Joe-Para/LSI_OTD/README.md

# LSI_OTD

A project for building the hardware and software for measuring time delay on fiber cables in distributed measurmeent systems.
