Joe-Para/LSI_OTD/PCB/Image file SchematicV1.1.png

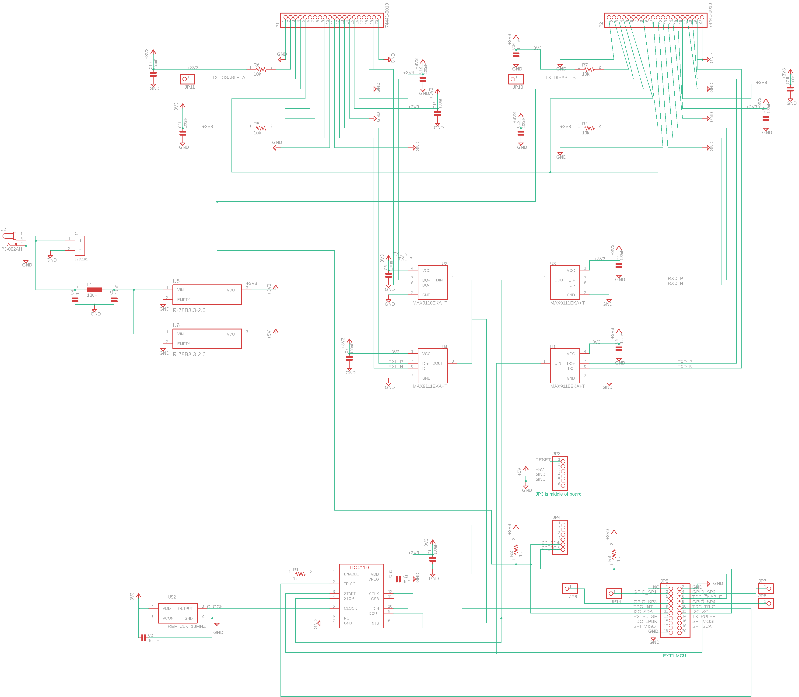
PCB/Image file SchematicV1.1.png
