Joe-Para/LSI_OTD/(threads)

Thread 1 (2019-04-17):

PCB Issues

Joe-Para, 2019-04-17:
- Need 5v switch with silkscreen warning
- SFP footprint lines up incorrectly
- Oscillator pads are a little small
- add more test points
- some silkscreen conflicts
- add footprint for sfp cages
- did not implement 4pin power header to MCU (mcu will need usb power)
- it would be nice to incorporate the RESET button on the display to the MCU (but i dont think there is room on the header)

-Edit: SFP Transceiver causes power to ground fault when plugged in

Joe-Para, 2019-04-24:
also oscillator datasheet recommends a 0.1uf cap as close as possible to the oscillator vdd and ground pins

Joe-Para, 2019-05-09:
Tim fixed all issues on pcb v2

Closed 2019-05-09.
