Joe-Para/LSI_OTD/PCB/SARA.pdf

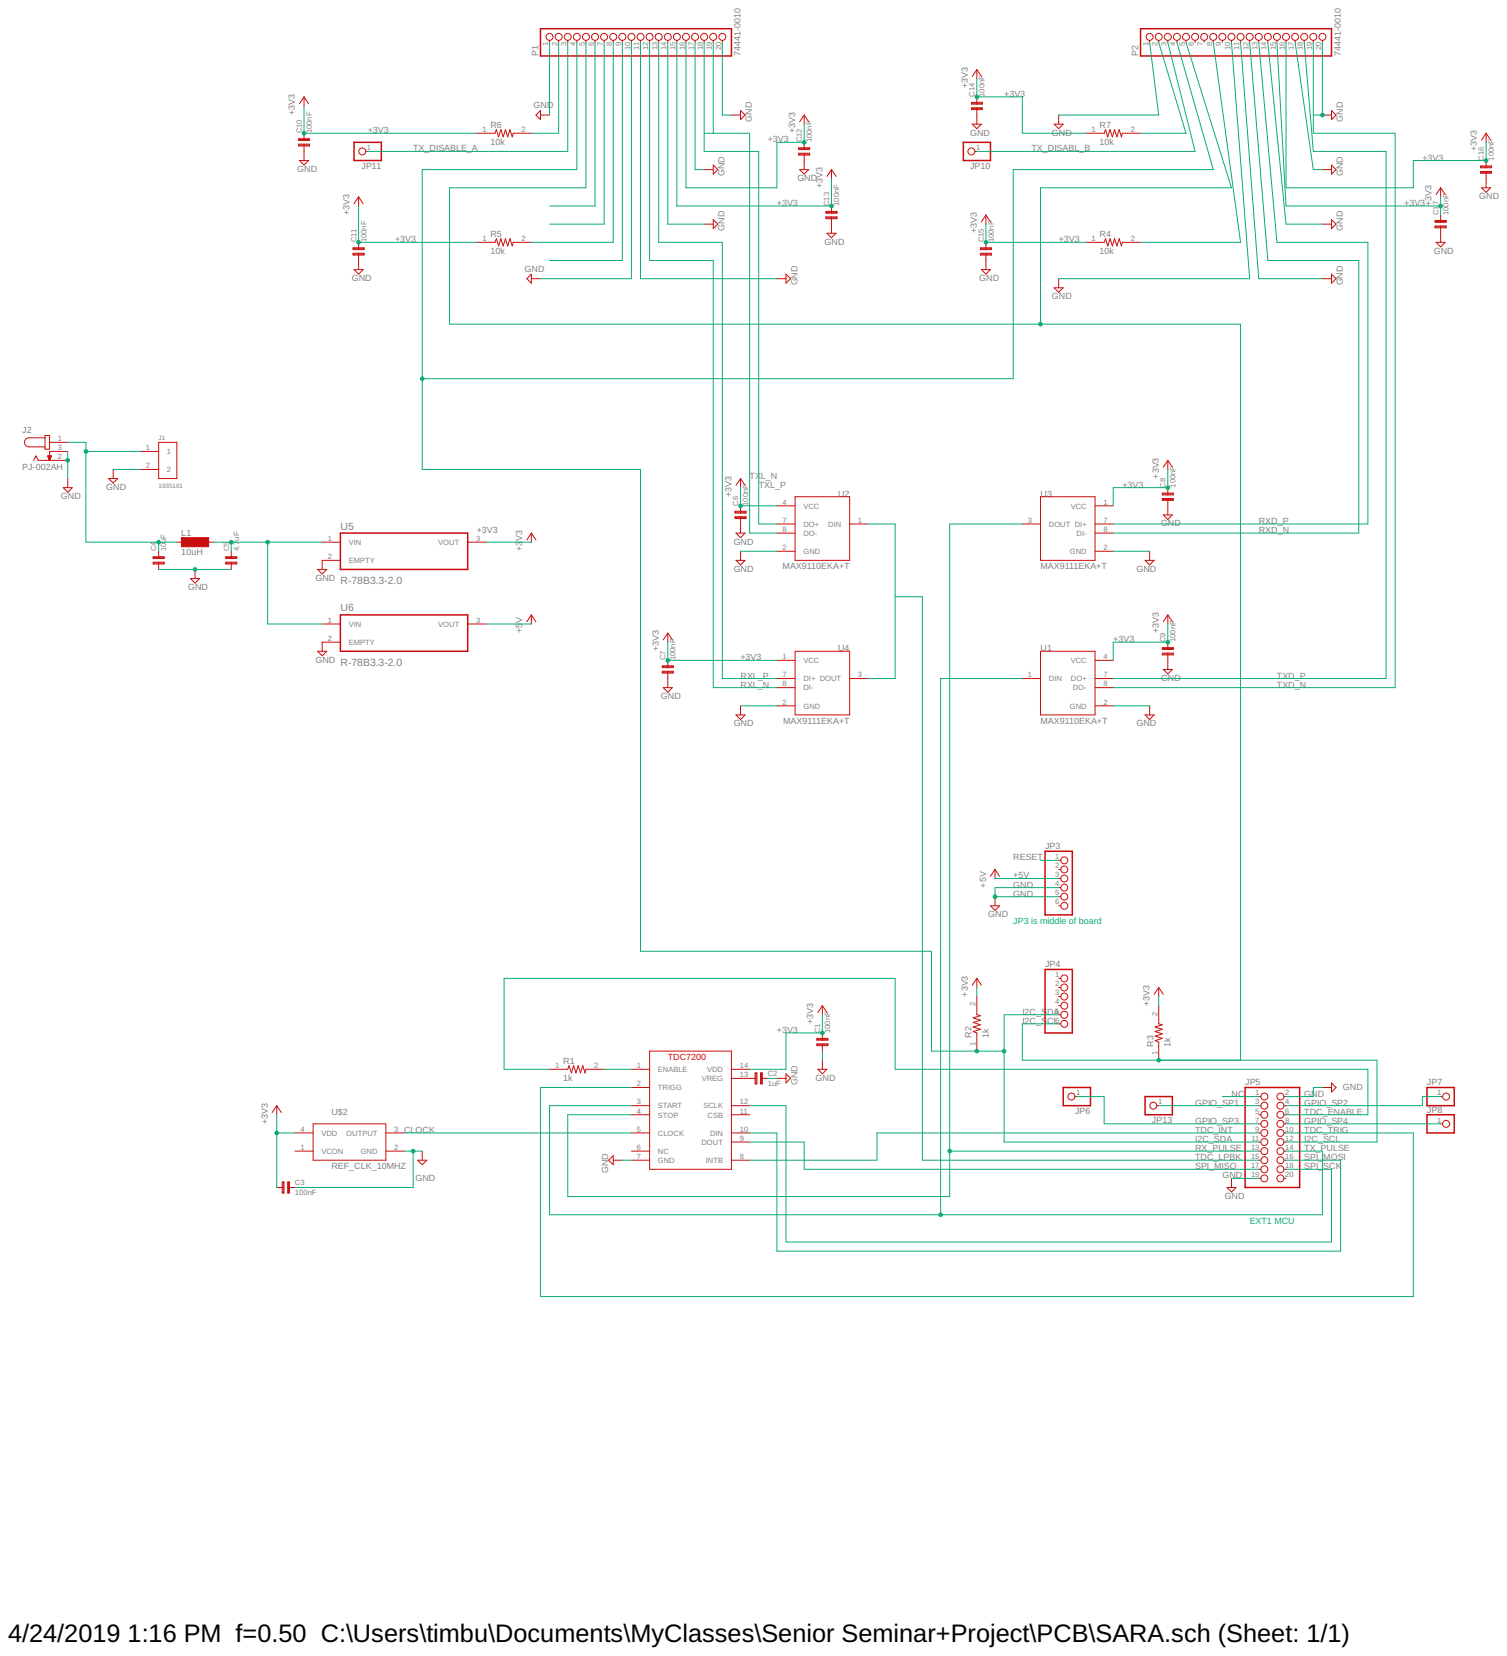
[picture p2: page 1]

JP3 is middle of board

4/24/2019 1:16 PM f=0.50 C:\Users\timbu\Documents\MyClasses\Senior Seminar+Project\PCB\SARA.sch (Sheet: 1/1)
