Joe-Para/LSI_OTD/PCB/SARA.brd

## EAGLE design PCB/SARA.brd (2019-05-14)

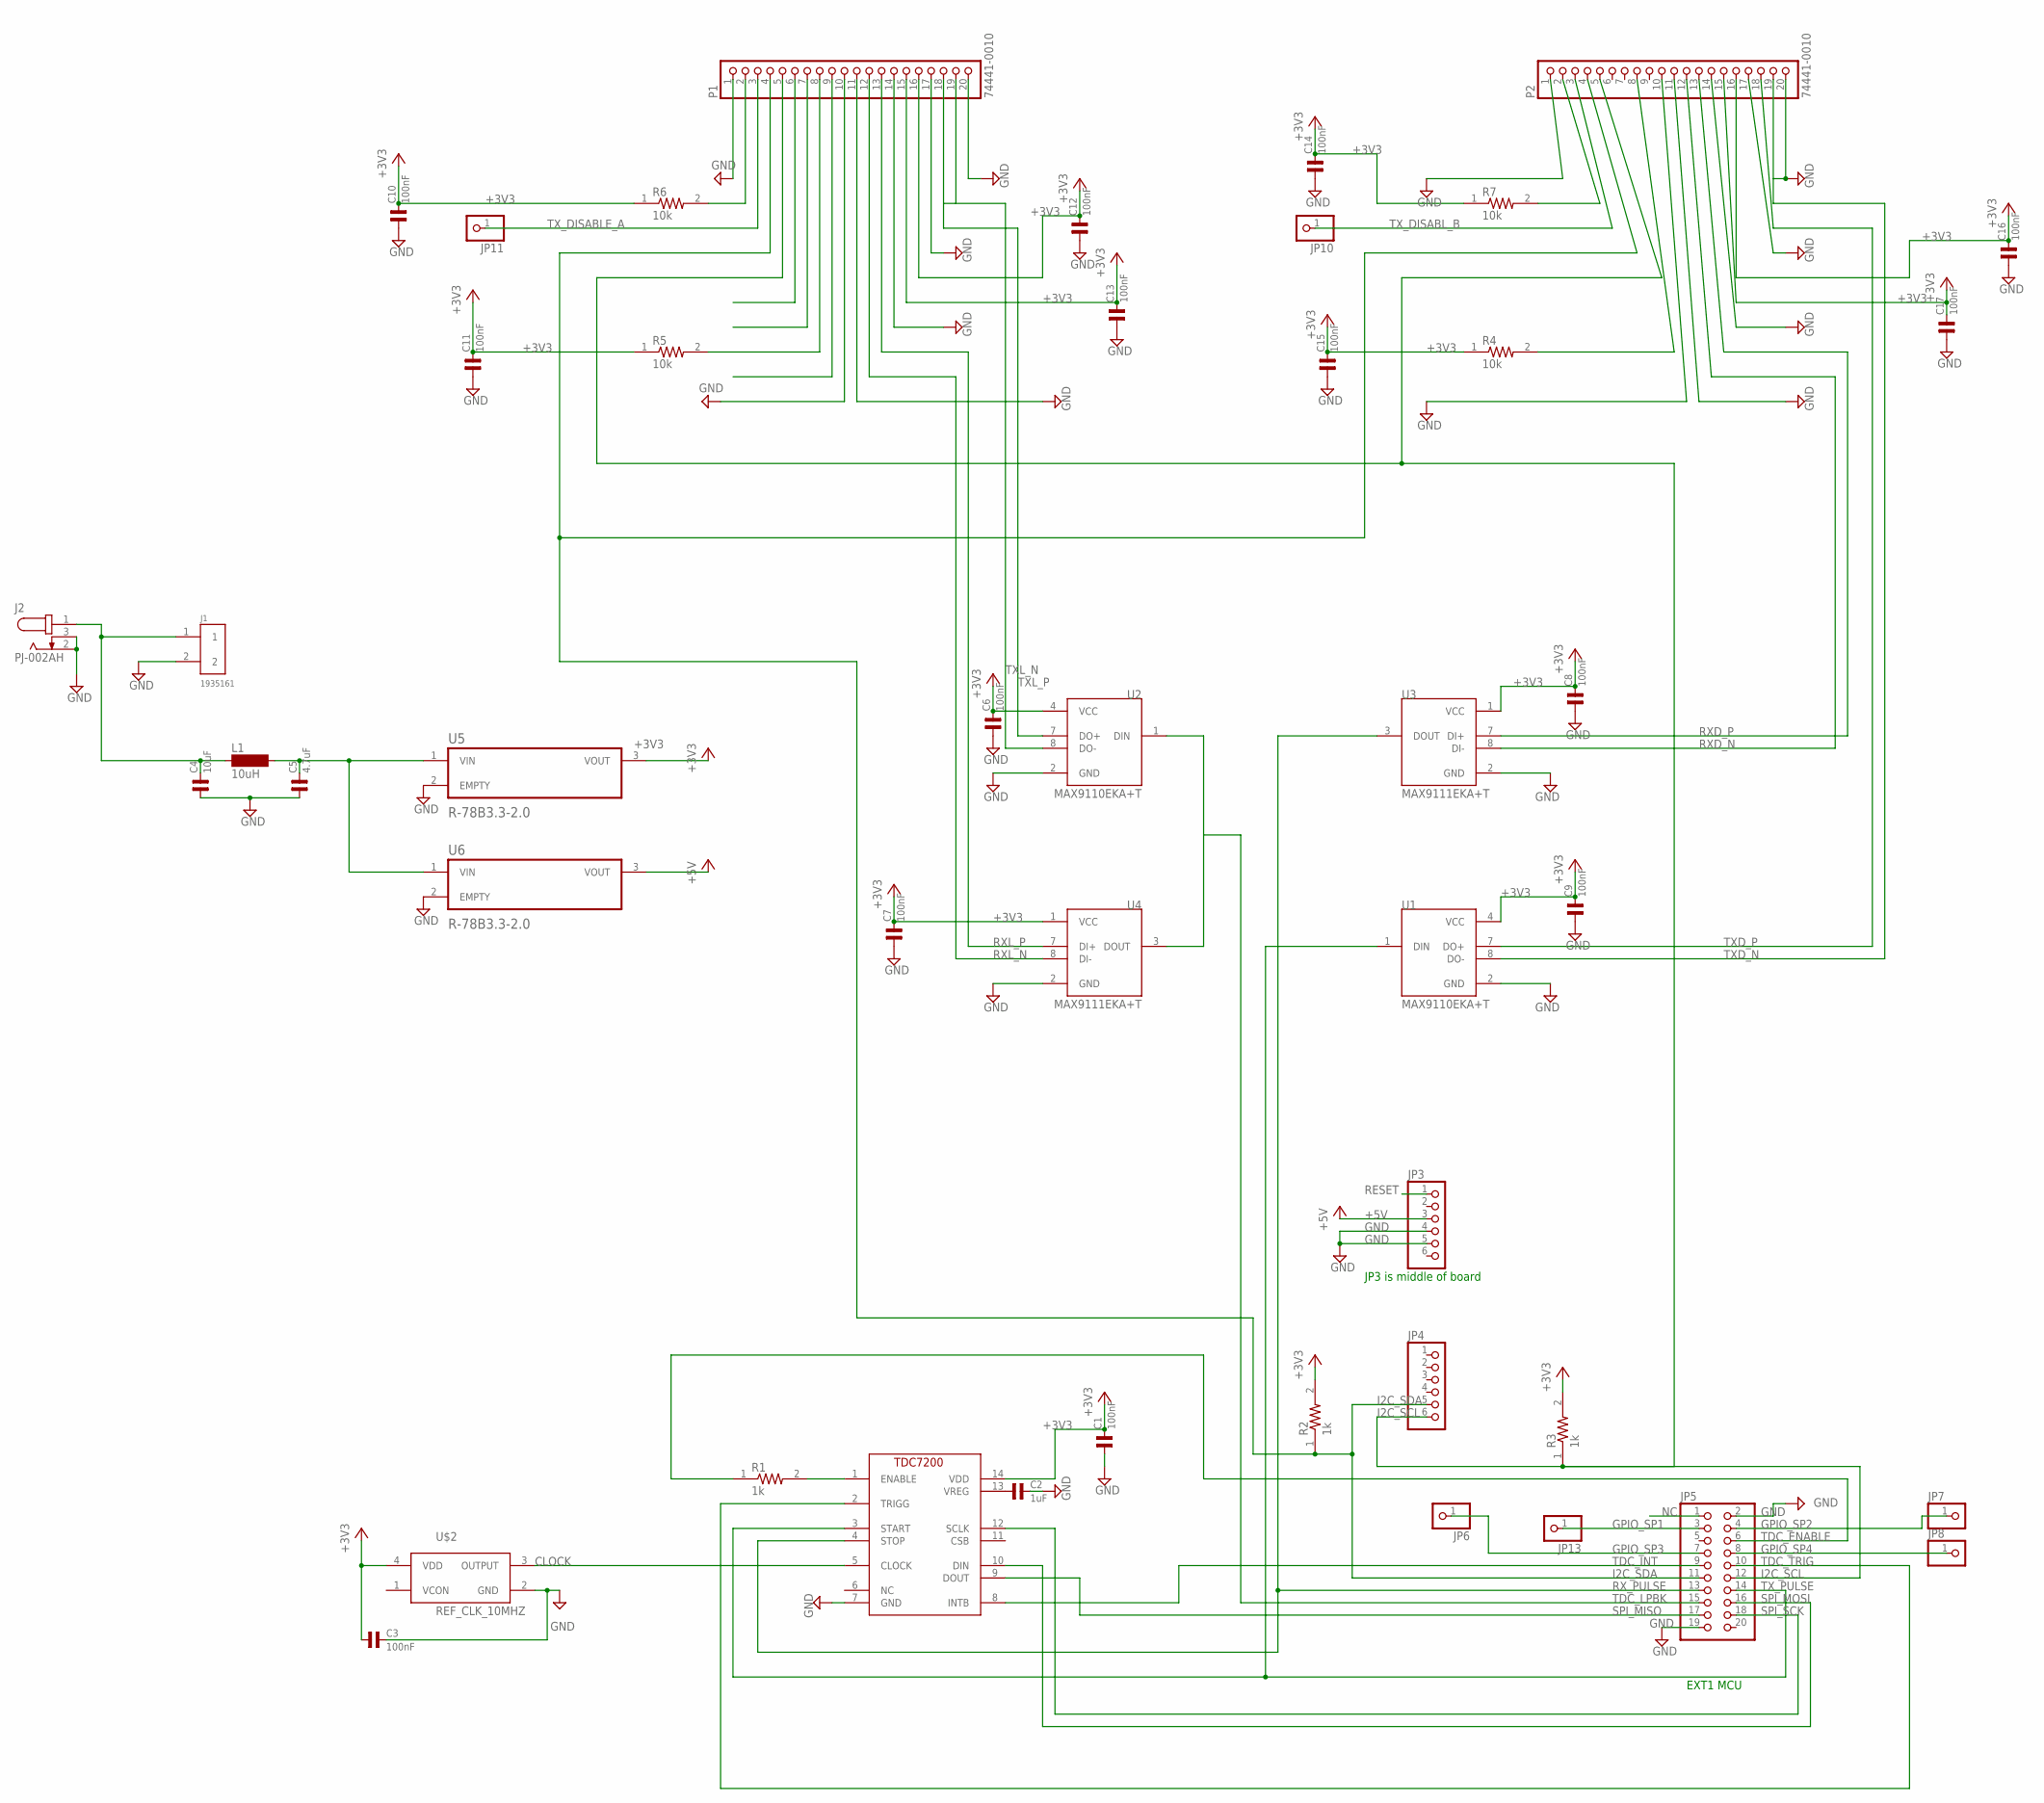
[picture p3: schematic SARA.sch]

Parts:
C1, C3, C6, C7, C8, C9, C10, C11, C12, C13, C14, C15, C16, C17: 100nF; 0603
C2: 1uF; 0603
C4: 10uF; 0603
C5: 4.7uF; 0603
J1: 1935161; PHOENIX_1935161
J2: PJ-002AH; CUI_PJ-002AH
JP3, JP4: PINHD-1X6; 1X06
JP5: PINHD-2X10; 2X10
JP6, JP7, JP8, JP10, JP11, JP13: PINHD-1X1; 1X01
L1: 10uH; MS50
P1, P2: 74441-0010; MOLEX_74441-0010
R1, R2, R3: 1k; RESC1608X55
R4, R5, R6, R7: 10k; RESC1608X55
U1, U2: MAX9110EKA+T; SOT65P280X145-8N
U3, U4: MAX9111EKA+T; SOT65P280X145-8N
U5, U6: R-78B3.3-2.0; CONV_R-78B15-2.0
U$1: TDC72007201PW; SOP65P640X120-14N
U$2: REF_CLK_10MHZ; TWETMCJANF-10.000000

Connections:
+3V3: C1.2, C3.1, C6.2, C7.2, C8.2, C9.2, C10.2, C11.2, C12.2, C13.2, C14.2, C15.2, C16.2, C17.2, P1.15, P1.16, P2.15, P2.16, R2.2, R3.2, R4.1, R5.1, R6.1, R7.1, U1.4 (VCC), U2.4 (VCC), U3.1 (VCC), U4.1 (VCC), U5.3 (VOUT), U$1.14 (VDD), U$2.4 (VDD)
+5V: JP3.3, U6.3 (VOUT)
CLOCK: U$1.5 (CLOCK), U$2.3 (OUTPUT)
GND: C1.1, C2.2, C3.2, C4.1, C5.1, C6.1, C7.1, C8.1, C9.1, C10.1, C11.1, C12.1, C13.1, C14.1, C15.1, C16.1, C17.1, J1.2, J2.2, J2.3, JP3.4, JP3.5, JP5.2, JP5.19, P1.1, P1.10, P1.11, P1.14, P1.17, P1.20, P2.1, P2.11, P2.14, P2.17, P2.20, U1.2 (GND), U2.2 (GND), U3.2 (GND), U4.2 (GND), U5.2 (EMPTY), U6.2 (EMPTY), U$1.7 (GND), U$2.2 (GND)
GPIO_SP1: JP5.3, JP13.1
GPIO_SP2: JP5.4, JP7.1
GPIO_SP3: JP5.7, JP6.1
GPIO_SP4: JP5.8, JP8.1
I2C_SCL: JP4.6, JP5.12, P1.5, P2.5, R3.1
I2C_SDA: JP4.5, JP5.11, P1.4, P2.4, R2.1
unnamed: P2.8, R4.2
unnamed: R1.2, U$1.1 (ENABLE)
unnamed: C2.1, U$1.13 (VREG)
unnamed: C5.2, L1.2, U5.1 (VIN), U6.1 (VIN)
unnamed: U2.1 (DIN), U4.3 (DOUT)
unnamed: P1.8, R5.2
unnamed: P1.2, R6.2
unnamed: P2.2, R7.2
unnamed: C4.2, J1.1, J2.1, L1.1
NC: JP5.1
RESET: JP3.1
RXD_N: P2.12, U3.8 (DI-)
RXD_P: P2.13, U3.7 (DI+)
RXL_N: P1.12, U4.8 (DI-)
RXL_P: P1.13, U4.7 (DI+)
RX_PULSE: JP5.13, U3.3 (DOUT), U$1.4 (STOP)
SPI_MISO: JP5.17, U$1.9 (DOUT)
SPI_MOSI: JP5.16, U$1.10 (DIN)
SPI_SCK: JP5.18, U$1.12 (SCLK)
TDC_ENABLE: JP5.6, R1.1
TDC_INT: JP5.9, U$1.8 (INTB)
TDC_LPBK: JP5.15
TDC_TRIG: JP5.10, U$1.2 (TRIGG)
TXD_N: P2.19, U1.8 (DO-)
TXD_P: P2.18, U1.7 (DO+)
TXL_N: P1.19, U2.8 (DO-)
TXL_P: P1.18, U2.7 (DO+)
TX_DISABLE_A: JP11.1, P1.3
TX_DISABL_B: JP10.1, P2.3
TX_PULSE: JP5.14, U1.1 (DIN), U$1.3 (START)

Notes on the sheet:
JP3 is middle of board
EXT1 MCU

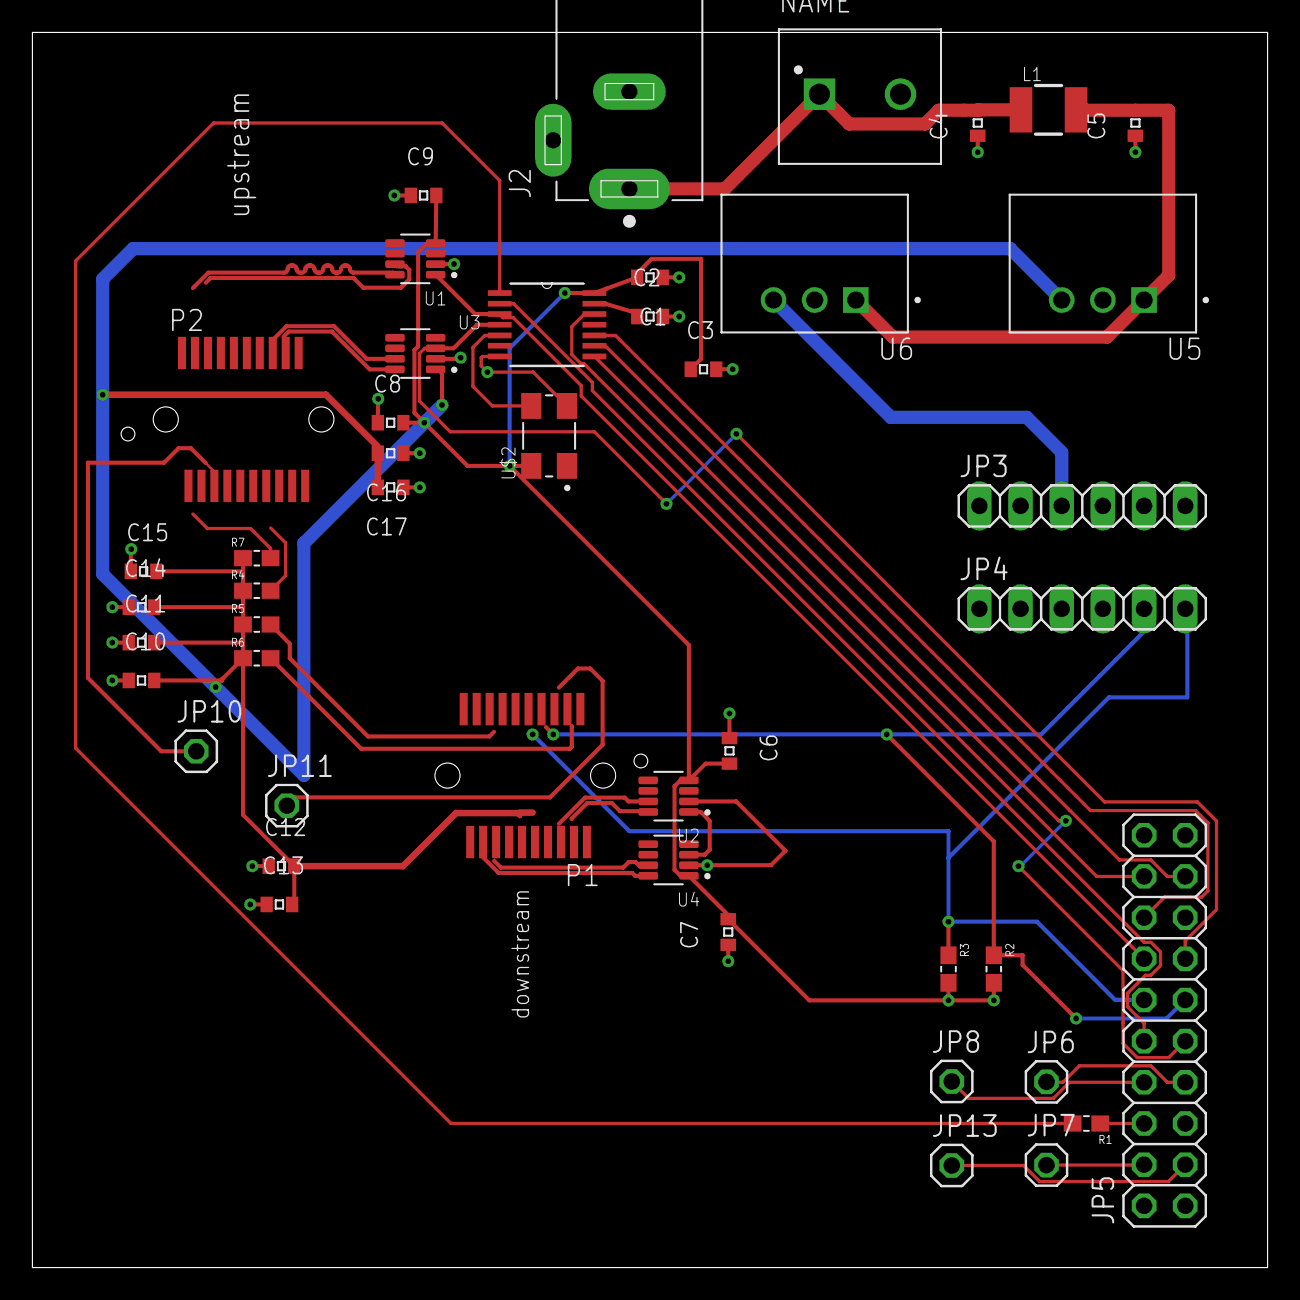
[picture p4: board SARA.brd from above]

Board: 2 copper layers, 76.2 x 76.2 mm, 46 parts (0 on the bottom side), 37 nets.
