Joe-Para/LSI_OTD/PCB/Senior Design Board V2.3.brd

## EAGLE design PCB/Senior Design Board V2.3.brd (2019-05-14)

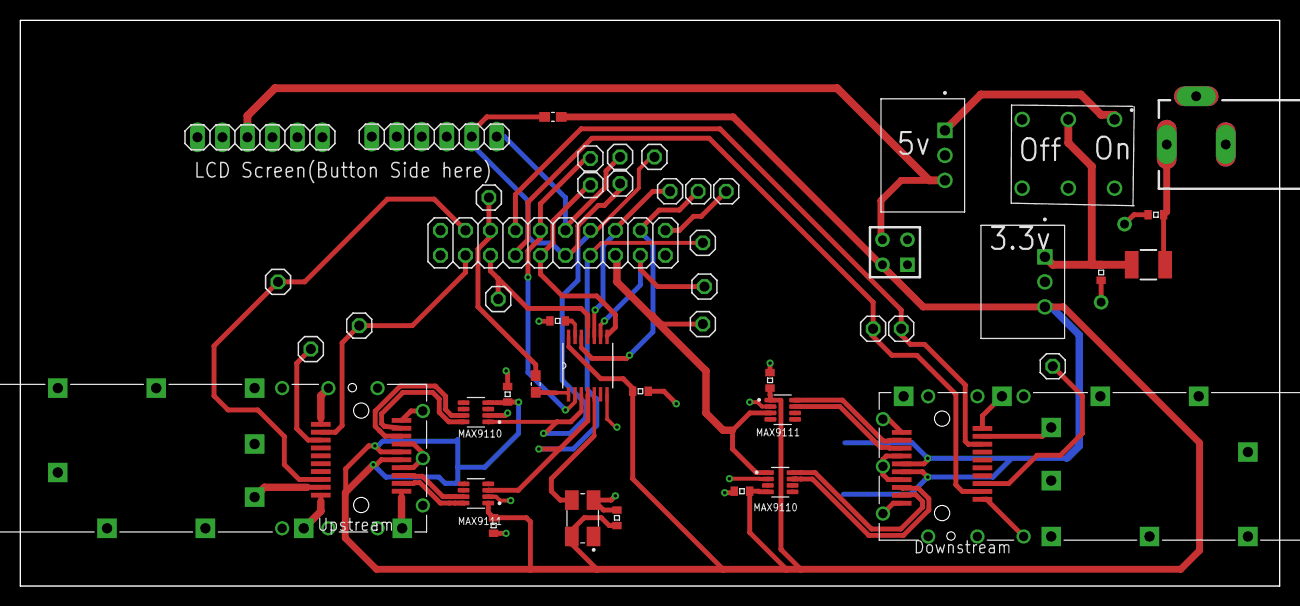
[picture p5: board Senior Design Board V2.3.brd from above]

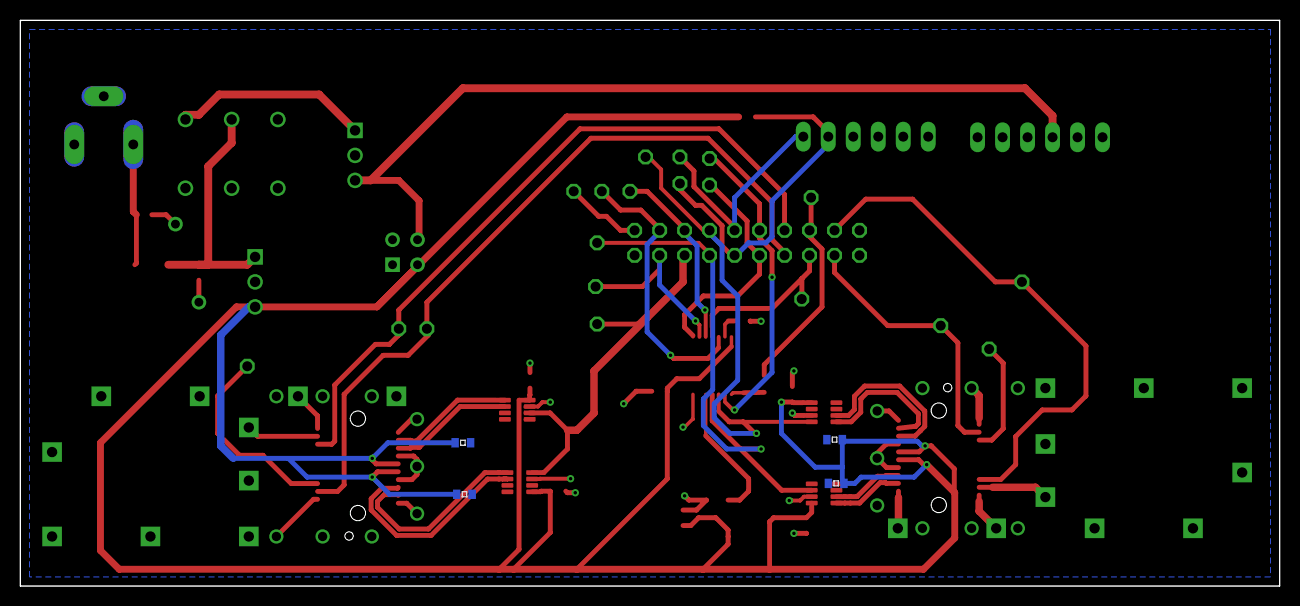
[picture p6: board Senior Design Board V2.3.brd from below]

Board: 2 copper layers, 128.0 x 57.5 mm, 53 parts (4 on the bottom side), 36 nets.

Parts:
C1: .1uf; 0603
C2: 1uF; 0603_C2
C3, C11, C18: 100nF; 0603
C4: 10uF; 0603_C2
C5: 4.7uF; 0603
C6: 100nF; 0603_C6
C14: 100nF; 0603_C2
C19, C20, C21, C22: 100nF; 0603_C19
GPIO_SPARE1, GPIO_SPARE2, GPIO_SPARE3, GPIO_SPARE4: 1X01
J1: 4840-2211
J3: HDR-2X2
JP3, JP4: 1X06
JP5: 2X10
JP10, JP11: 1X01
L1: 10uH; MS50
PAD63, PAD80: PAD
R1: 1k; RESC1608X55
R2: 1k; RESC1608X55_R2
SW1: DEV_SW1; P137
TDC: TDC72007201PW; SOP65P640X120-14N
TESTPIN5, TESTPIN6: 1X01
TP9, TP10, TP11, TP12, TP13, TP14, TP15, TP16, TP18, TP20: 1X01
TP_17: 1X01
U1, U2: MAX9110EKA+T; SOT65P280X145-8N
U3, U4: MAX9111EKA+T; SOT65P280X145-8N
U5, U6: R-78B3.3-2.0; CONV_R-78B15-2.0
U7: DEV_U7; P159
U8: DEV_U8; P17
U$2: REF_CLK_10MHZ; TWETMCJANF-10.000000

Connections:
3.3_V: C1.2, C3.2, C6.1, C11.2, C14.2, C18.1, C19.2, C20.2, C21.1, C22.1, J3.2, R2.2, TDC.14, U1.4, U2.4, U3.1, U4.1, U5.3, U7.15, U7.16, U8.15, U8.16, U$2.4
12V: C5.2, L1.2, SW1.3_3, U5.1
+5V: J3.4, JP3.3, U6.3
CLOCK: TDC.5, U$2.3
I2C_SCL: JP4.6, JP5.12, TP12.1
I2C_SDA: JP4.5, JP5.11, R2.1, TP11.1
unnamed: C2.1, TDC.13
unnamed: C4.2, J1.1, L1.1
NET_0: SW1.2_1, U6.1
NET_35: JP5.20, TP20.1
POWER_GROUND: C1.1, C2.2, C3.1, C4.1, C5.1, C6.2, C11.1, C14.1, C18.2, C19.1, C20.1, C21.2, C22.2, J1.2, J1.3, J3.1, JP3.5, JP5.2, JP5.19, PAD63.1, PAD80.1, SW1.3_1, SW1.3_2, TDC.7, U1.2, U2.2, U3.2, U4.2, U5.2, U6.2, U7.1, U7.9, U7.10, U7.11, U7.14, U7.17, U7.20, U7.S1, U7.S2, U7.S3, U7.S5, U7.S6, U7.S7, U7.S8, U7.S9, U7.S10, U7.S11, U7.S12, U7.S13, U7.S14, U7.S15, U7.S16, U7.S17, U7.S18, U7.S19, U7.S20, U8.1, U8.9, U8.10, U8.11, U8.14, U8.17, U8.20, U8.S1, U8.S2, U8.S3, U8.S5, U8.S6, U8.S7, U8.S8, U8.S9, U8.S10, U8.S11, U8.S12, U8.S13, U8.S14, U8.S15, U8.S16, U8.S17, U8.S18, U8.S19, U8.S20, U$2.2
RD_DOWN_N: U4.8, U8.12
RD_DOWN_P: U4.7, U8.13
RD_UP_N: U3.8, U7.12
RD_UP_P: U3.7, U7.13
RX_LOSS_DOWN: GPIO_SPARE4.1, JP5.8, U8.8
RX_LOSS_UP: GPIO_SPARE2.1, JP5.4, U7.8
RX_PULSE: JP5.13, TDC.4, TP13.1, U3.3
SPI_MISO: JP5.17, TDC.9, TP_17.1
SPI_MOSI: JP5.16, TDC.10, TP16.1
SPI_SCK: JP5.18, TDC.12, TP18.1
TDC_CSB: JP5.5, TDC.11, TESTPIN5.1
TDC_ENABLE: R1.2, TDC.1
TDC_ENABLE_1: JP5.6, R1.1, TESTPIN6.1
TDC_INT: JP5.9, TDC.8, TP9.1
TDC_LPBK: JP5.15, TP15.1, U2.1, U4.3
TDC_TRIG: JP5.10, TDC.2, TP10.1
TD_DOWN_N: U2.8, U8.19
TD_DOWN_P: U2.7, U8.18
TD_UP_N: U1.8, U7.19
TD_UP_P: U1.7, U7.18
TX_DISABLE_DOWN: JP11.1, U8.3
TX_DISABLE_UP: JP10.1, U7.3
TX_FAULT_DOWN: GPIO_SPARE3.1, JP5.7, U8.2
TX_FAULT_UP: GPIO_SPARE1.1, JP5.3, U7.2
TX_PULSE: JP5.14, TDC.3, TP14.1, U1.1
