Joe-Para/LSI_OTD/Node/LSI_OTD/LSI_OTD/communications_setup.h

/*
 * communications_setup.h
 *
 * Created: 4/12/19 2:05:24 AM
 *  Author: Jacob Candelaria
 */ 


#ifndef COMMUNICATIONS_SETUP_H_
#define COMMUNICATIONS_SETUP_H_

//workstation IP address - must be sent on current network
#define workstationIP_0		10
#define workstationIP_1		0
#define workstationIP_2		2
#define workstationIP_3		247

//main and secondary connection ports
#define MC_PORT				8000
#define SC_PORT				9000

#include <atmel_start.h>
#include <peripheral_clk_config.h>
#include <lwip/netif.h>
#include <lwip/timers.h>
#include "lwip_demo_config.h"
#include <string.h>
#include <lwip/tcp.h>
#include <lwip/dhcp.h>
#include <main.h>

void client_close(struct tcp_pcb *pcb);
err_t client_connected(void *arg, struct tcp_pcb *pcb, err_t err);
err_t client_recv(void *arg, struct tcp_pcb *pcb, struct pbuf *p, err_t err);
err_t client_poll(void *arg, struct tcp_pcb *pcb);
err_t client_err(void *arg, err_t err);
err_t client_sent(void *arg, struct tcp_pcb *pcb, u16_t len);
bool compareString(char *string1, char *string2, int string2Len);
void start_ethernet();

void runCommand(char *string);
extern int connectionCount;
extern unsigned char state;
extern unsigned char flags;

#endif /* COMMUNICATIONS_SETUP_H_ */
