Joe-Para/LSI_OTD/(commit log)

2019-04-03 added eagle files
    [SARA.brd, SARA.sch]
2019-04-03 Create Folder Structure
    [SARA.brd, SARA.sch]
2019-04-03 Node + Workstation Folders w/ Workstation Program & Interrupt Program
2019-04-04 renamed EXT1 pins and named differential traces
2019-04-04 90% done routing, renamed stuff and added differental traces.
    [SARA.brd, SARA.sch]
2019-04-09 Finished Proto 1 PCB from cameron
    [SARA.brd, SARA.sch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]
2019-04-10 Fixed node prototype - working tcp client. Ready for demo.
    [main.c]
2019-04-12 Renamed pcb to TCPpcb & modified runCommand function to ensure each command sends a reply back to workstation
2019-04-12 Fixed communicationCount, added MC_PORT and SC_PORT for config
    [communications_setup.c, communications_setup.h, main.c]
2019-04-12 Added workstation config file and added functionality to print errors to .error file
2019-04-13 SPI setup added
2019-04-13 added tdc driver
2019-04-13 fixed include and typing bugs for spi and tdc
    [main.c, spi_setup.c, spi_setup.h, tdc7200.c, tdc7200.h]
2019-04-13 added TDC_DEBUG macro, can now use TDC_DEBUG(message) for handy printf to serial output. can be mass disabled by TDC_DEBUG_ON set to 0
2019-04-16 Fixed typos in tdc7200
    [tdc7200.c]
2019-04-17 added i2c stuff
2019-04-17 Disable all LWIP debugging + fixed Ping sent message error
    [main.c]
2019-04-18 Fixed TCPpcb naming error
    [communications_setup.c, communications_setup.h]
2019-04-19 fixed i2c not showing up in project
2019-04-25 Fixed typo in pull mode for TX_FAULT_DOWN
    [driver_init.c]
2019-04-26 Set pull down resistors on interrupt pins
2019-05-04 Friday working stuff with tx_disable(low output) & rx_loss(pull-up resistor)
2019-05-05 Current Debug state.....RX_Pulse is sent to output for testing TDC
2019-05-10 Current Node + Workstation...Ready for Final Demo
2019-05-13 Master cleanup & comments - remove node prototype code
2019-05-14 Added Tim's PCB v2 files
    [SARA.brd, SARA.sch, Senior Design Board V2.3.brd]
